enzoflores98/VOICEBOT/CODIGO PPS/configuracion_pps.py

# configuracion.py

PUERTO_COM = 'COM3'
TASA_BAUDIOS = 9600
URL_CAMARA = "http://192.168.1.33:4747/video"
CLAVE_API_OPENAI = '' # Clave de API, solicitar al creador del proyecto en caso de requerir una prueba

POSICION_HOME = [90, 90, 90, 90, 90, 90]  # Valores de ejemplo
POSICION_A1 = [45, 45, 45, 45, 45, 45]    # Valores de ejemplo
POSICION_A2 = [135, 135, 135, 135, 135, 135]  # Valores de ejemplo
ALTURA_MINIMA_GRIPPER = 10  # Valor de ejemplo
